BinaryMan32/phoenix-arduino/(threads)

Thread 1 (2021-01-28):

Shouldn't the 4 arrow buttons be programmed as a pov hat? Is there a way to do that?

Jackinator675, 2021-01-28:
Shouldn't the 4 arrow buttons be programmed as a pov hat? Is there a way to do that? I'd like to use this template to modify my own controller, but it seems like those 4 red arrow buttons on the end of the arm should be a pov hat.

BinaryMan32, 2021-01-29:
I agree completely, and I've already implemented this, but it's not enabled by default. Please take a look at a56efee85180f14b54b3d86505a40519486dda27 and search for `VIRTUAL_HAT`.

I didn't update the screenshot after I added this functionality, so I can see why you'd think it wasn't implemented. Let me know if it helps you!

Jackinator675, 2021-02-24:
Thank you for that clarification.

Closed 2021-02-24.
