BinaryMan32/phoenix-arduino/(commit log)

2018-03-30 start from https://playground.arduino.cc/Code/ShiftRegSN74HC165N
2018-03-30 handle phoenix pcb sharing clock and read on a single wire
    Able to read all 8 buttons from the handle pcb.
2018-03-31 Arduino IDE requires the .ino file name matches the directory
2018-03-31 images: add top image to slider pcb
2018-04-03 images: wing_pcb: correct ribbon button pin descriptions
    Experimentation showed that the ribbon pins connected to the throttle
    HC165 were arranged in the same order as the pins connected to the
    HC165 directly on the wing pcb.
2018-04-03 test reading potentiometers with analog inputs
    To demo reading the analogs potentiometers continuously and still be able
    to see button presses, skip printing the analogs while a button is down.
    [phoenix-arduino.ino]
2018-04-28 follow Arduino 1.5 library specification
    Must now be cloned into your user libraries directory, on windows the
    default is:
    ~/Documents/Arduino/libraries/
    https://github.com/arduino/arduino/wiki/arduino-ide-1.5:-library-specification
2018-04-28 map potentiometer resistance to output range
    Add independent mappings for each potentiometer so they can be calibrated
    based on measured resistances at the limits of the physical range of
    movement.
2018-04-28 doc: show prototyping setup and explain phoenix-arduino-test.ino
2018-04-29 Potentiometer.h: fix include guard
    [Potentiometer.h]
2018-04-29 README.md: add link to Arduino Nano
2018-04-29 add HidDescriptorHelper.h
    HidDescriptorHelper makes it easier to construct USB HID device
    descriptors using many enums to descrive the structure.
2018-04-29 examples: add phoenix-arduino-joystick
    Create another example which should enumerate as a USB HID Joystick on the
    attached computer and send the axes and button states in a report message.
    This example works only on Arduino devices with HID support. These devices
    use the main processor to access USB instead of a separate processor, which
    allows them to provide additional USB endpoints that can be accessed
    directly by the implementation.
2018-05-02 adjust pin mapping for Arduino Micro
2018-05-02 document phoenix-arduino-joystick and HidDescriptorHelper
2018-05-11 pin layout updates for new board
2018-05-13 remap button order to something more sensible
    The hardware button ordering is based on where the traces could get from
    buttons to the hc165. Create a virtual button ordering with a more human
    friendly order. Reordered the throttle buttons to come before the wing
    buttons in case programs support only a smaller number of buttons, since
    the throttle buttons are in a more accessible location.
2018-05-13 hat switch experiments
2018-05-13 phoenix-arduino-joystick: turn on LED during setup() as sign of life
2019-02-21 phoenix-arduino-joystick: fix bad var ref 'color' and set color to red
    [phoenix-arduino-joystick.ino]
2019-02-21 examples: phoenix-arduino-joystick: use 10 bits per axis
    Avoid integer overflow issues by using only 10 bits per axis instead
    of 16 bits.
    [phoenix-arduino-joystick.ino]
2019-02-22 phoenix-arduino-joystick: add time histogram
    if TIME_HISTOGRAM is defined, dump a histogram of the time between loop()
    iterations when button 0 is pressed.
    The period is approximately 10-11ms
2019-02-22 examples: phoenix-arduino-joystick: add support for virtual hat
    Create a virtual POV HAT control from 4 separate buttons.
